theoneandonlyalfre2/self-balancing-robot/mechanical/pcb-deck/criterios_diseno.md

# Segundo piso — criterios de diseño

La PCB original se inspecciona en modo de solo lectura y no se modifica.

Datos extraídos del sólido PCB importado en Fusion (mm): contorno rectangular X=84…222, Y=−154…−38, Z=0…1,44. Dimensiones: 138 × 116 × 1,44. Centro: (153, −96).

Orificios de fijación: cuatro cilindros pasantes Ø3,2; centros originales (142,8; −136,7), (192,6; −136,7), (100; −41,6), (187,1; −45,6). No se sustituyen por un patrón regular.

Orientación en el robot: rotación +90° sobre Z, centrada respecto de la base. Transformación: Xrobot=−Ypcb−96; Yrobot=Xpcb−153. Centros resultantes: (40,7; −10,2), (40,7; 39,6), (−54,4; −53), (−50,4; 34,1).

Los 22 cuerpos importados abarcan Z=−1,94…17,56 respecto de la cara inferior del sustrato. Este es el contenido del modelo suministrado; no supone que todos los módulos enchufables estén modelados.

Plataforma propuesta: 136 × 164 × 4 mm, con cara inferior a Z=60 mm; margen de 6,7 mm sobre las placas de motor. Separadores estructurales desmontables: 55 mm, entre Z=5 y Z=60, situados en los cuatro anclajes existentes de la base (±32,1; ±27), Ø8 exterior y taladro Ø3,4.

Separadores aislantes de PCB: 6 mm de altura y Ø6 exterior, en los centros medidos. Cara inferior de PCB a Z=70 mm; holgura bajo los salientes modelados de 4,06 mm respecto de la plataforma.

Anclajes auxiliares M3 de paso Ø3,4 en el borde exterior de la PCB: dos filas laterales con paso 20 mm y cuatro agujeros en cada extremo. Dos pasos de cable junto a los extremos y ventanas de ventilación bajo la PCB. Las fijaciones del piso se montan antes de colocar la PCB.

Es una primera pieza geométrica para prototipo. La selección del material, la resistencia bajo carga y el espacio de las futuras ruedas y módulos no forman parte de la verificación dimensional del modelo.
