theoneandonlyalfre2/self-balancing-robot/mechanical/motor-base/Base_NEMA17_AS5600.png

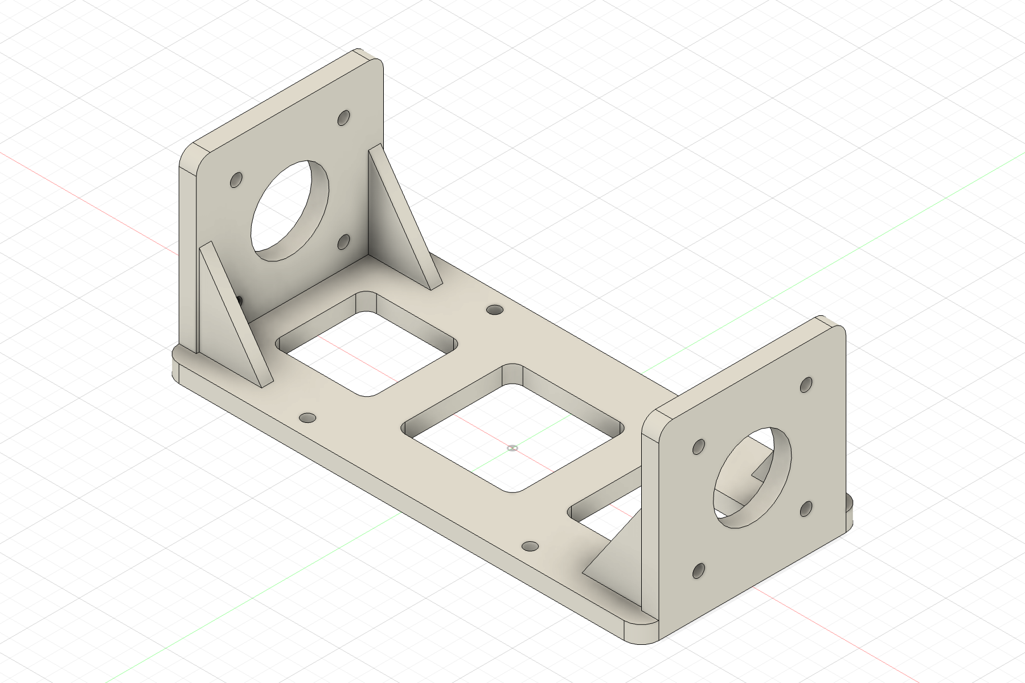
mechanical/motor-base/Base_NEMA17_AS5600.png
