theoneandonlyalfre2/self-balancing-robot/mechanical/pcb-deck/PCB_inspeccion_superior.png

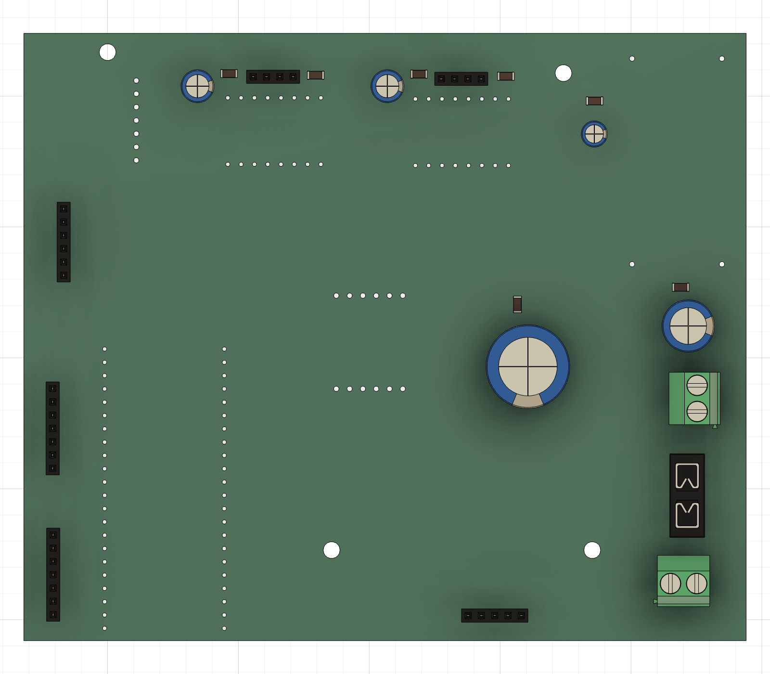
mechanical/pcb-deck/PCB_inspeccion_superior.png
