theoneandonlyalfre2/self-balancing-robot/mechanical/pcb-deck/Plataforma_PCB.png

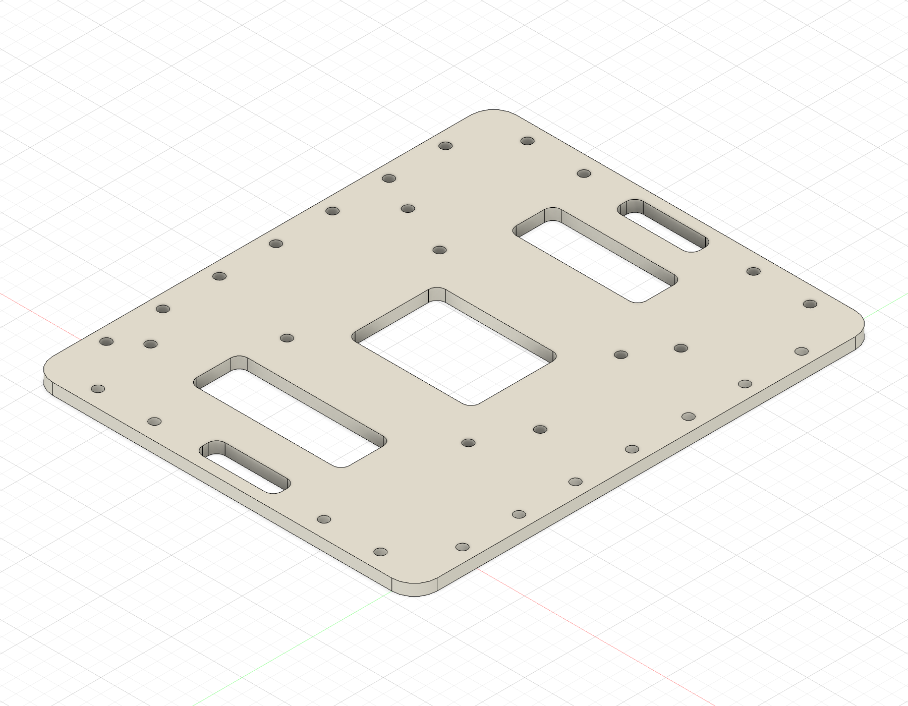
mechanical/pcb-deck/Plataforma_PCB.png
