theoneandonlyalfre2/self-balancing-robot/hardware/models/pcb.step

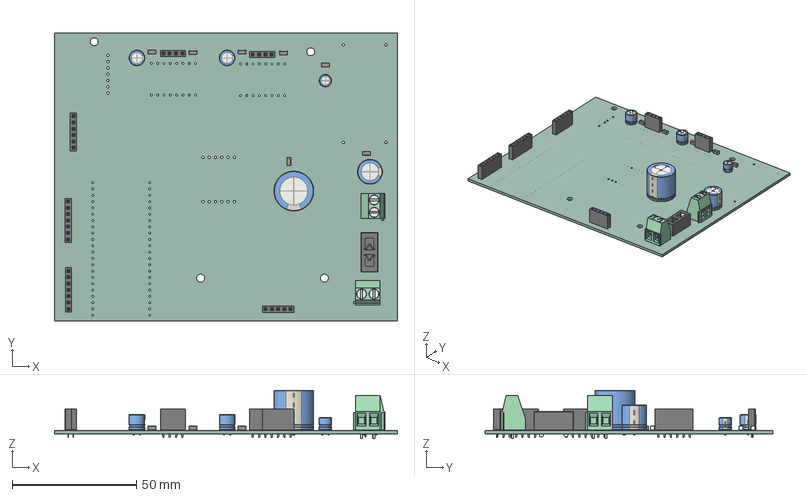
[picture p5: CAD file, 2026-10-15]
hardware/models/pcb.step
138.0 x 116.0 x 19.5 mm
TerminalBlock_Phoenix_MKDS-1,5-2_1x02_P5.00mm_Horizontal x 2
PinSocket_1x07_P2.54mm_Vertical x 2
CP_Radial_D63mm_P250mm x 2
C_1206_3216Metric x 7
PinSocket_1x04_P2.54mm_Vertical x 2
CP_Radial_D100mm_P500mm
CP_Radial_D50mm_P250mm
PinSocket_1x05_P2.54mm_Vertical
PinSocket_1x06_P2.54mm_Vertical
A_Keystone_3568
CP_Radial_D160mm_P750mm
Circuito Self-Balancing Robot-unsaved-export-CIjhw4_PCB
