theoneandonlyalfre2/self-balancing-robot/mechanical/motor-base/Base_NEMA17_AS5600.step

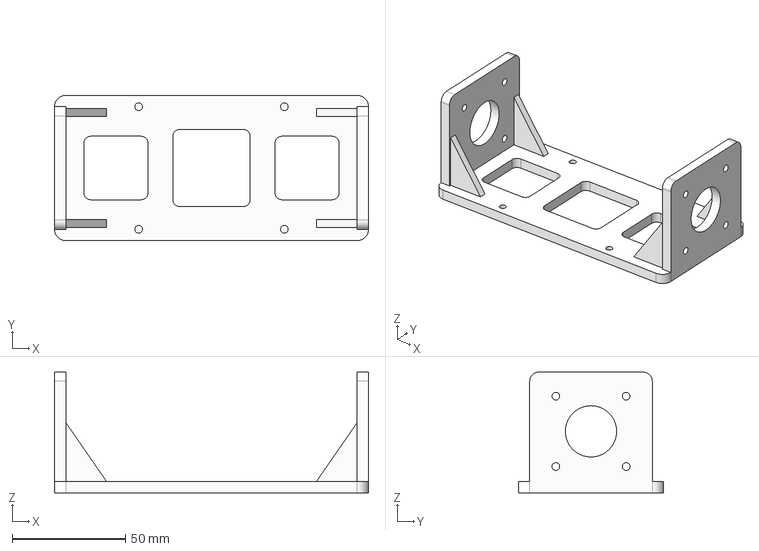
[picture p6: CAD file, 2026-10-15]
mechanical/motor-base/Base_NEMA17_AS5600.step
138.4 x 64.0 x 53.3 mm
