theoneandonlyalfre2/self-balancing-robot/mechanical/pcb-deck/Plataforma_PCB.step

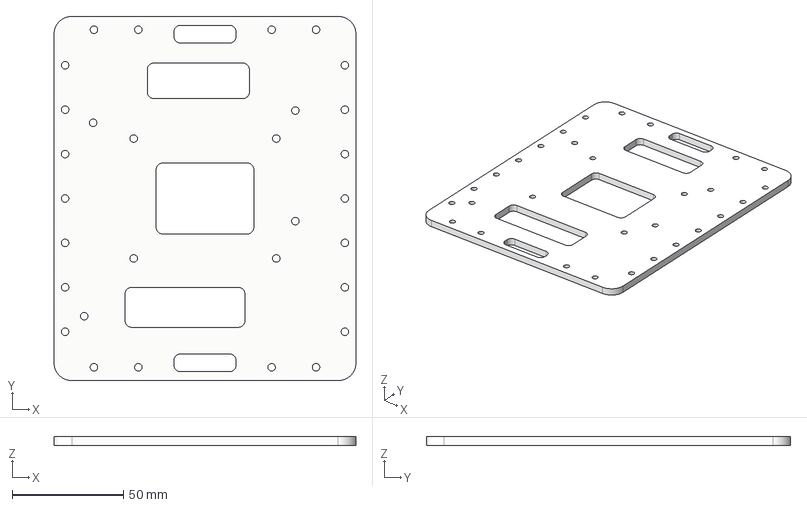
[picture p7: CAD file, 2026-10-15]
mechanical/pcb-deck/Plataforma_PCB.step
136.0 x 164.0 x 4.00 mm
