theoneandonlyalfre2/self-balancing-robot/mechanical/pcb-deck/Separador_PCB_6mm_cantidad_4.step

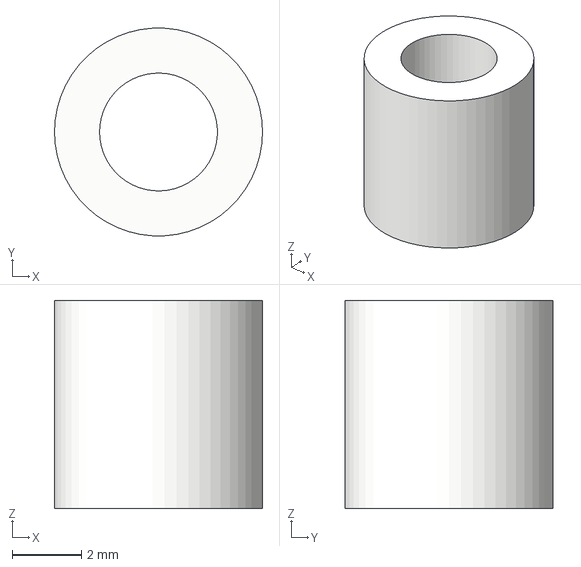
[picture p8: CAD file, 2026-10-15]
mechanical/pcb-deck/Separador_PCB_6mm_cantidad_4.step
6.00 x 5.99 x 6.00 mm
