theoneandonlyalfre2/self-balancing-robot/mechanical/pcb-deck/Columna_55mm_cantidad_4.step

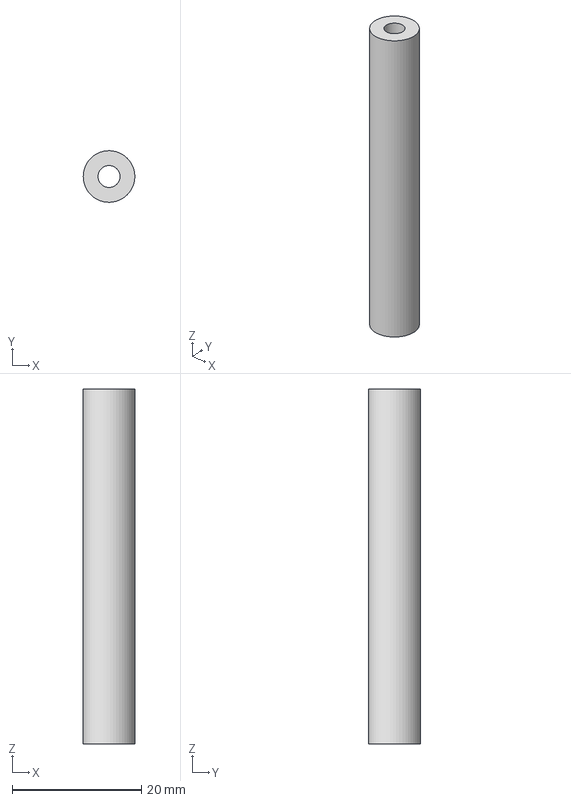
[picture p9: CAD file, 2026-10-15]
mechanical/pcb-deck/Columna_55mm_cantidad_4.step
7.99 x 8.00 x 55.0 mm
