theoneandonlyalfre2/self-balancing-robot/(list of files, cad)

Other CAD files:
mechanical/pcb-support-original/01 Base imprimible.3mf
mechanical/motor-base/Base_NEMA17_AS5600.f3d
mechanical/motor-base/Base_NEMA17_AS5600.stl
mechanical/pcb-deck/Chasis_robot_segundo_piso_PCB.f3d
mechanical/pcb-deck/Columna_55mm_cantidad_4.stl
mechanical/pcb-deck/Plataforma_PCB.stl
mechanical/pcb-deck/Separador_PCB_6mm_cantidad_4.stl
