theoneandonlyalfre2/self-balancing-robot/hardware/manufacturing/README.md

# Exportaciones de fabricación

Se conservan dos conjuntos del 5 de octubre de 2026:

- `2026-10-05_1525`: exportación encontrada junto al proyecto KiCad.
- `2026-10-05_1537`: exportación posterior encontrada en la carpeta First PCB.

El proyecto PCB editable se guardó a las 17:53 de ese día. Estas exportaciones no se han regenerado desde ese archivo ni se ha comprobado su equivalencia con él. Son versiones históricas de trabajo, no una entrega validada para fabricar.

Cada conjunto mantiene sus nombres y su archivo `.gbrjob`. El conjunto de las 15:37 conserva dos archivos de serigrafía frontal; el `.gbrjob` referencia `F_Silkscreen.gbr`. No combines automáticamente archivos de ambas carpetas.

Los metadatos de la exportación posterior indican dos capas, aproximadamente 138,05 × 116,05 mm y espesor total de 1,6 mm. Antes de fabricar, revisar el diseño actual y generar un nuevo juego completo tras sus comprobaciones eléctricas y de reglas de diseño.
