theoneandonlyalfre2/self-balancing-robot/mechanical/motor-base/Montaje_referencia.png

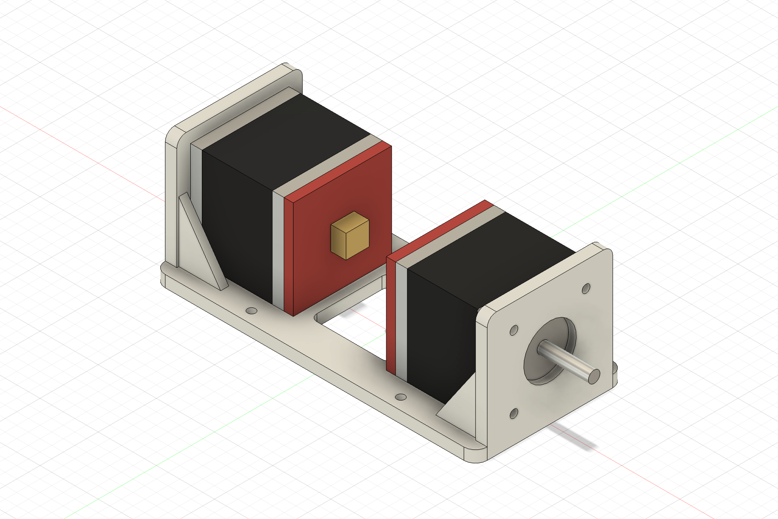
mechanical/motor-base/Montaje_referencia.png
