theoneandonlyalfre2/self-balancing-robot/mechanical/pcb-deck/Montaje_sin_PCB.png

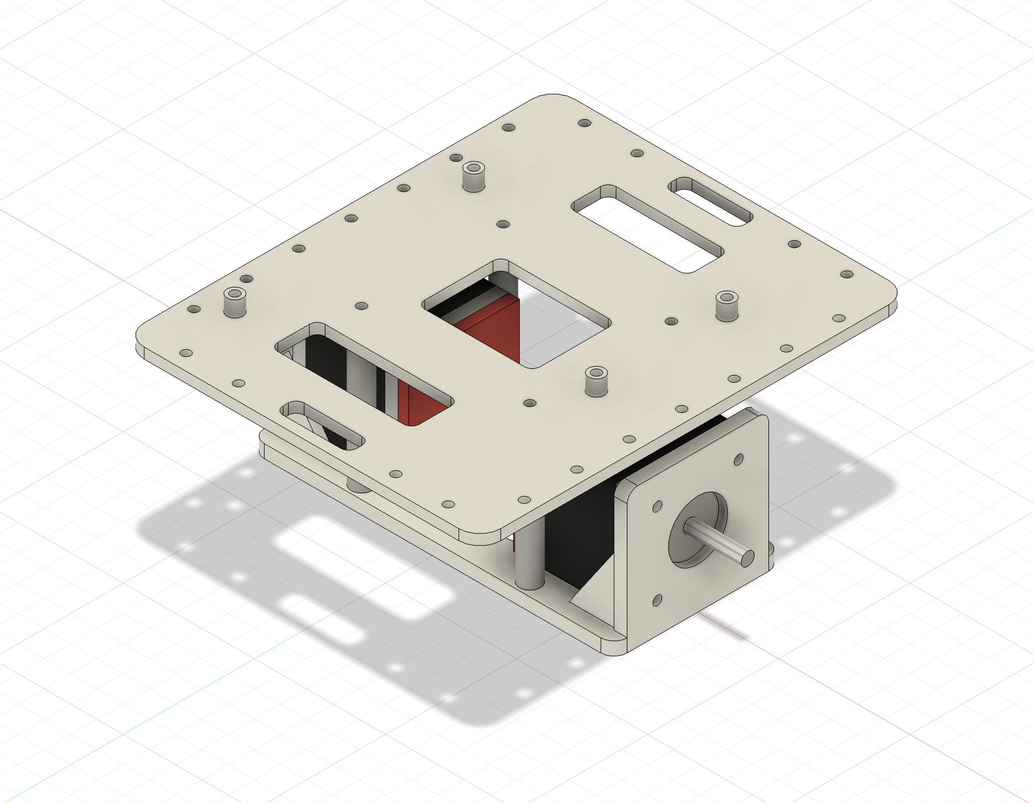
mechanical/pcb-deck/Montaje_sin_PCB.png
