theoneandonlyalfre2/self-balancing-robot/hardware/kicad/Circuito Self-Balancing Robot.kicad_pcb

## KiCad design hardware/kicad/Circuito Self-Balancing Robot.kicad_pcb (2026-10-15)

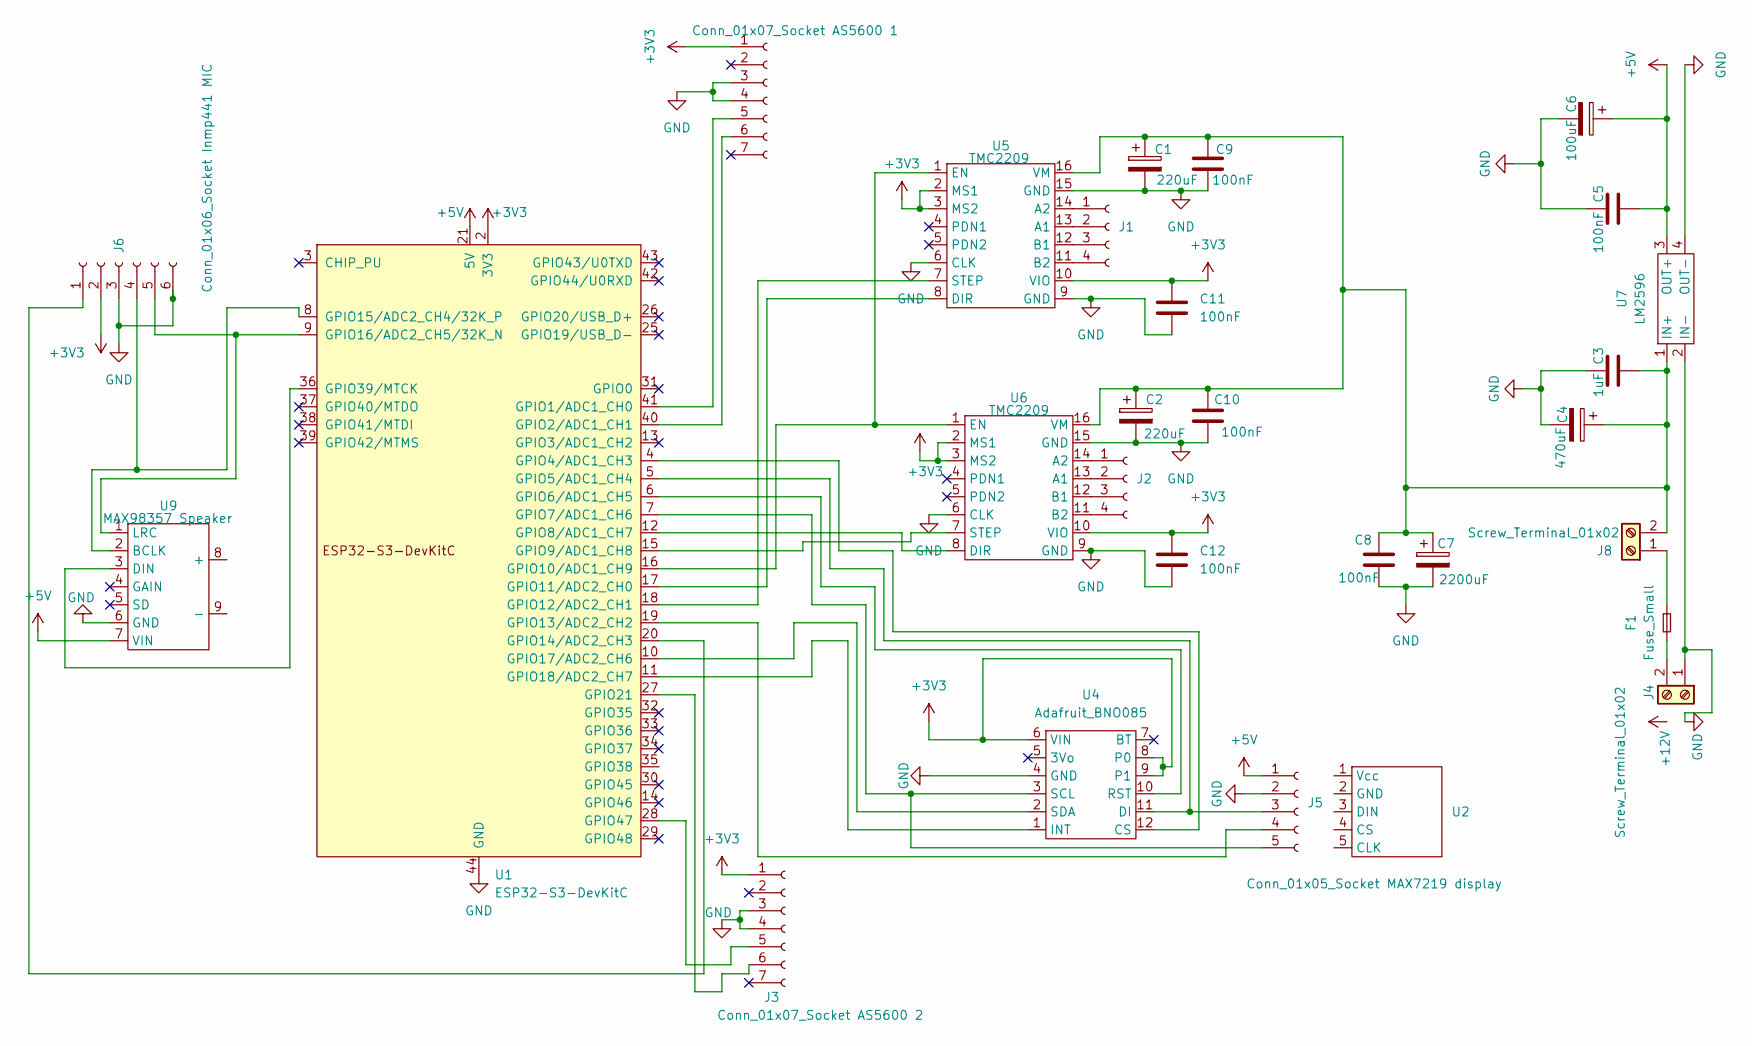
[picture p12: schematic Circuito Self-Balancing Robot.kicad_sch]

Parts:
C1, C2: 220uF; CP_Radial_D6.3mm_P2.50mm
C3: 1uF; C_1206_3216Metric
C4: 470uF; CP_Radial_D10.0mm_P5.00mm
C5, C8, C9, C10, C11, C12: 100nF; C_1206_3216Metric
C6: 100uF; CP_Radial_D5.0mm_P2.50mm
C7: 2200uF; CP_Radial_D16.0mm_P7.50mm
F1: Fuse_Small; Fuseholder_Blade_Mini_Keystone_3568
J1, J2: Conn_01x04_Socket; PinSocket_1x04_P2.54mm_Vertical
J3: Conn_01x07_Socket AS5600 2; PinSocket_1x07_P2.54mm_Vertical
J4, J8: Screw_Terminal_01x02; TerminalBlock_Phoenix_MKDS-1,5-2_1x02_P5.00mm_Horizontal
J5: Conn_01x05_Socket MAX7219 display; PinSocket_1x05_P2.54mm_Vertical
J6: Conn_01x06_Socket Inmp441 MIC; PinSocket_1x06_P2.54mm_Vertical
J7: Conn_01x07_Socket AS5600 1; PinSocket_1x07_P2.54mm_Vertical
U1: ESP32-S3-DevKitC
U2: 7SegmentLED_LTS6760_LTS6780
U4: Adafruit_BNO085; BNO085 footprint
U5, U6: TMC2209; Pololu_Breakout-16_15.2x20.3mm
U7: LM2596; LM2595 Footprint
U9: MAX98357 Speaker; MAX98357

Connections:
+3V3: C11.1, C12.1, J3.1, J6.2, J7.1, U1.1 (3V3), U1.2 (3V3), U4.6 (VIN), U4.8 (P0), U4.9 (P1), U5.2 (MS1), U5.3 (MS2), U5.10 (VIO), U6.2 (MS1), U6.3 (MS2), U6.10 (VIO)
+5V: C5.2, C6.1, J5.1, U1.21 (5V), U7.3 (OUT+), U9.7 (VIN)
GND: C1.2, C2.2, C3.1, C4.2, C5.1, C6.2, C7.2, C8.2, C9.2, C10.2, C11.2, C12.2, J3.3, J3.4, J4.1, J5.2, J6.3, J6.6, J7.3, J7.4, U1.22 (GND), U1.23 (GND), U1.24 (GND), U1.44 (GND), U4.4 (GND), U5.6 (CLK), U5.9 (GND), U5.15 (GND), U6.6 (CLK), U6.9 (GND), U6.15 (GND), U7.2 (IN-), U7.4 (OUT-), U9.6 (GND)
unnamed: J1.1, U5.14 (A2)
unnamed: J1.2, U5.13 (A1)
unnamed: J1.3, U5.12 (B1)
unnamed: J1.4, U5.11 (B2)
unnamed: J2.1, U6.14 (A2)
unnamed: J2.2, U6.13 (A1)
unnamed: J2.3, U6.12 (B1)
unnamed: J2.4, U6.11 (B2)
unnamed: J3.5, U1.28 (GPIO47)
unnamed: J3.6, U1.27 (GPIO21)
unnamed: F1.1, J4.2
unnamed: J5.3, U1.5 (GPIO5/ADC1_CH4), U4.11 (DI)
unnamed: J5.4, U1.19 (GPIO13/ADC2_CH2)
unnamed: J5.5, U1.7 (GPIO7/ADC1_CH6), U4.3 (SCL)
unnamed: J6.1, U1.20 (GPIO14/ADC2_CH3)
unnamed: J6.4, U1.8 (GPIO15/ADC2_CH4/32K_P), U9.2 (BCLK)
unnamed: J6.5, U1.9 (GPIO16/ADC2_CH5/32K_N), U9.1 (LRC)
unnamed: J7.5, U1.41 (GPIO1/ADC1_CH0)
unnamed: J7.6, U1.40 (GPIO2/ADC1_CH1)
unnamed: F1.2, J8.1
unnamed: C1.1, C2.1, C3.2, C4.1, C7.1, C8.1, C9.1, C10.1, J8.2, U5.16 (VM), U6.16 (VM), U7.1 (IN+)
unnamed: U1.4 (GPIO4/ADC1_CH3), U4.12 (CS)
unnamed: U1.6 (GPIO6/ADC1_CH5), U4.10 (RST)
unnamed: U1.12 (GPIO8/ADC1_CH7), U6.8 (DIR)
unnamed: U1.15 (GPIO9/ADC1_CH8), U6.7 (STEP)
unnamed: U1.16 (GPIO10/ADC1_CH9), U5.1 (EN), U6.1 (EN)
unnamed: U1.17 (GPIO11/ADC2_CH0), U5.8 (DIR)
unnamed: U1.18 (GPIO12/ADC2_CH1), U5.7 (STEP)
unnamed: U1.10 (GPIO17/ADC2_CH6), U4.2 (SDA)
unnamed: U1.11 (GPIO18/ADC2_CH7), U4.1 (INT)
unnamed: U1.36 (GPIO39/MTCK), U9.3 (DIN)

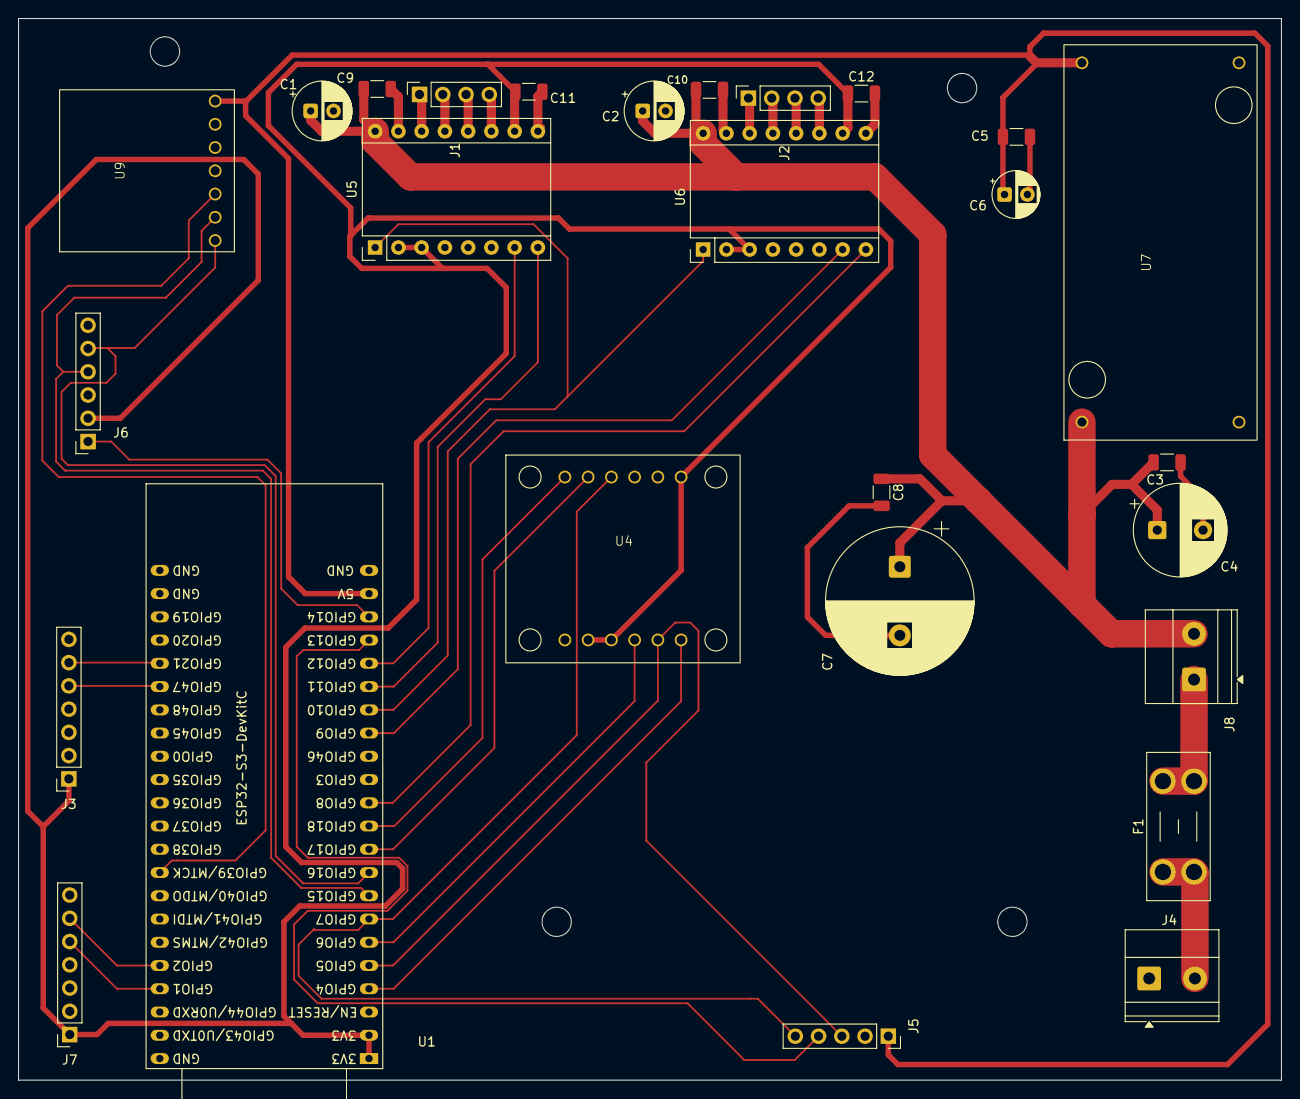
[picture p13: board Circuito Self-Balancing Robot.kicad_pcb from above]

Board: 2 copper layers, 138.0 x 116.0 mm, 27 parts (0 on the bottom side), 34 nets.
